minkang543/Microfluidic-RGB-Sensor/Microfluidic Chip Project Report.pdf

# MICROFLUIDIC CHIP PROJECT REPORT

Kaitlyn Nguyen

Emily Gao

Mharlo Borromeo

Min Kang

Ryan Luong

Michelle Tran

ENGR 7B: Introduction to Engineering

University of California, Irvine

Winter 2023

Potato Chip 1

## Table of Contents

Executive Summary | 2
Problem Definition | 3
Introduction | 3
Technical Review / Background | 3
Design Requirements | 3
Design Description | 4
Summary of Design | 4
Design Details | 4
Wiring Diagram | 5
Algorithm Design | 6
Action Item Report | 7
Task Assignment | 7
Gantt Chart | 8
Timeline | 8
Evaluation | 10
Calculations | 10
Calibration Curve | 10
Test Plan | 11
Results & Discussion | 12
Appendix A: SOLIDWORKS Drawings | 14
Appendix B: Bill of Materials | 23
Appendix C: Arduino Code | 24
Appendix D: Volume Calculations | 27
Appendix E: References | 29

## Executive Summary

Our goal for this project was to create a microfluidic system that could detect the concentration of any unknown solution with the use of an rgb sensor. For this project, we had to detect the concentration of fluorescein in the solution given to us. Our team created a chip made of Polydimethylsiloxane (PDMS) along with housing that would prevent light pollution to the chip and hold our electronic components. In order to fill the requirements of the project successfully, our team split up and focused on specialized tasks. This included learning how to laser cut, 3D print, code with arduino, circuit analysis, and learn chemical calibration. As we progressed throughout these ten weeks and learned these new skills, we proceeded with the construction of the system that would meet the design requirements.

We completed the system over a span of ten weeks. The first two weeks were spent brainstorming a design for a system, and deciding the size of the staging wells, detection well, waste well, and channels. After that, our mechanical and electrical hardware team spent the third and fourth week creating a preliminary design for the chip and the housing. Our design was then approved and we spent week five finalizing the details and modifying our design with the advice of our advisor. Once the design was finalized, we began the fabrication process by building the housing, cutting out the chip cover, creating the mold for the PDMS, and fabricating the PDMS chip. We also began the coding process during the sixth week, and this continued with the flowchart, troubleshooting, and debugging up until the final competition. We completed the fabrication of the system during week eight, which is also when we created the stock solutions and began calibration. This also continued until the final competition. We were able to meet our goal of detecting the amount of fluorescein in the solutions with the RGB sensor, though our results were not what we had expected. This could be due to an error in the fabrication of the system itself and the equipment, or some small errors in the code.

Throughout this process we did not only gain technical knowledge in the programs we used, but also the process of engineering. We learned that time management for this project was extremely important, as we had deadlines for several different aspects of the project, as well as the challenging and time consuming process of trial and error. Though we may have had brilliant ideas that should have worked on paper, reality presented us with several challenges. However, this also allowed us to focus on the importance of communication and teamwork, as well as working with others in the field of engineering.

## Problem Definition

I. Introduction
We were tasked to build a microfluidic system that can detect the concentration of fluorescein in a solution. There are many applications to this system that we have studied in class, such as using other solutions with different colors for disease detection, or blood tests. These miniaturized labs help with portability and accessibility, as well as being a cheaper method of testing.
II. Technical Review / Background

The origin of microfluidics is mostly associated with the work done in the late 1960s at Stanford University on chromatography and IBM’s ink jet printer nozzles. Both of these utilized micromechanics to create these microfluidic devices. There is also evidence that hundreds of years earlier, researchers such as Hippocrates (400 BC), Galen (200 AD), and Theophilus (700 AD) were already interested in subjects that pertained to microfluidic technology. Although they didn’t have the devices and technology themselves, the idea of creating microfluidic devices has already been present for several centuries.
In recent years, the advancement of technology has brought on more sophisticated microfluidics. The development has allowed these systems to use less samples and reagents, increased portability, low energy consumption, rapid response, and several other advantages that would help with the analysis of these solutions. There is even potential for connecting these microfluidic devices to smartphones, and taking advantage of the features available in them; especially the optical detection system. ¹
III. Design Requirements

As part of our product specifications, we were given that the feature size should be at least 150 um and the channel width be between 150 um and 400 um. Detection well is designed to store 3 uL of fluorescein solution. As for our structure, we were allowed to use either PDMS and
PMMA, and we decided to use both, one for the chip (PDMS) and the holders with PMMA. We made sure to use gloves during PDMS fabrication to avoid stains as suggested. We 3D printed components (specifically our darkness chamber) and also created a holder to house the LED and an enclosure for the entire system. We made sure that our wires and connectors are completely covered and insulated by threading them through the bottom of the housing platform. Our total cost to build the device was less than $350, as the budget sheet will later on show. Finally, our product deliverables were as follows: the lab-on-a-chip microfluidic device, a detection concentration of an unknown fluorescein solution, the final design report, and the oral presentation.

1 Castillo-León Jaime, and Winnie E. Svendsen. “Chapter 1 Microfluidics and Lab-on-a-Chip Devices: History and Challenges.” Lab-on-a-Chip Devices and Micro-Total Analysis Systems a Practical Guide , Springer International Publishing, Cham, 2015.

## Design Description

I. Summary of Design
Our design for our microfluidic system consists of a chip created by PDMS held together by two holders made of PMMA material. There is an RGB Sensor screwed into a holder made of wood and screwed into the chip, and the chip itself with the sensor is screwed into the housing, which is then covered by a darkness chamber that was 3D printed and painted black with acrylic paint. The top of the housing also holds the breadboard and arduino, which are also connected to the RGB sensor held on top of the chip. In order to prevent as much light entering the system as possible, the wires are fed through two holes that will go under the darkness chamber. The blue LED is held under the housing platform with a small piece of wood, and is connected to a resistor.

II. Design Details

A. Microfluidic Chip (refer to Appendix A. Page 14)
The microfluidic chip contains four staging wells; each with a diameter of 4mm. All four staging wells flow into 150μm channels that meet and flow into a 300μm channel to go into the detection well. The intention of making two different sizes is to prevent backflow with capillary action. To further ensure that there is no backflow, the chip has four capillary valves connected to the staging wells that each have a diameter of 1mm. The 300μm channel to the detection continues to the waste well that has a semi-minor radius of 2.50mm and semi-major radius of 6.40mm.
B. Chip Holder (refer to Appendix A. Page 15 & 16)
Two pieces of PMMA Acrylic were used to sandwich the PDMS chip. This prevented the PDMS material from getting soiled with any dirt from the outside environment. Aside from that, the chip holder was intended to prevent air bubbles that can allow liquid to flow outside of the system
C. RGB Sensor Holder (refer to Appendix A. Page 17)
The RGB sensor holder positions the RGB sensor in a position above the detection well of the PDMS chip to detect fluorescein concentration with the ambient light.
D. Detection Well (refer to Appendix A. Page 14)
The main channel is the 300μm channel, which leads to the elliptical detection well with a semi-minor radius of 1.59mm and semi-major radius of 3mm.
E. Darkness Chamber + Housing (refer to Appendix A. Page 18 & 19)
The darkness chamber (painted black) was 3-D printed and used to cover the RGB sensor to increase light detection for accurate results.
F. Overview/final assembly (refer to Appendix A. Page 20 & 21)
The chip is covered by the Darkness Chamber to ensure that no ambient light interferes with the detection well. The box is 8in x 8in, made out of wood, and we painted the housing and chamber black to ensure the absorption of all light. The Arduino Uno circuit is screwed on next to the darkness chamber and the breadboard is next to it. The wiring from the Arduino circuit goes into the holes we drilled in the box and connects to the chip underneath. There are also multiple tubes connected to the chip which allows us to easily pump different concentrations of fluid into the chip for detection.

III. Wiring Diagram

Our electrical diagram contained an Arduino Uno and RGB sensor to detect the amount of fluorescein concentration in our chip. The way in which the amount of fluorescein could be detected was with how many red LEDs light up during the experiment. We had 8 red LEDs with resistors of the same resistance for all attached to them to demonstrate the amount of fluorescein solution, with one blue LED connected to the bottom of our housing platform. The blue wires signal anything not connected to ground (black) or voltage (red).

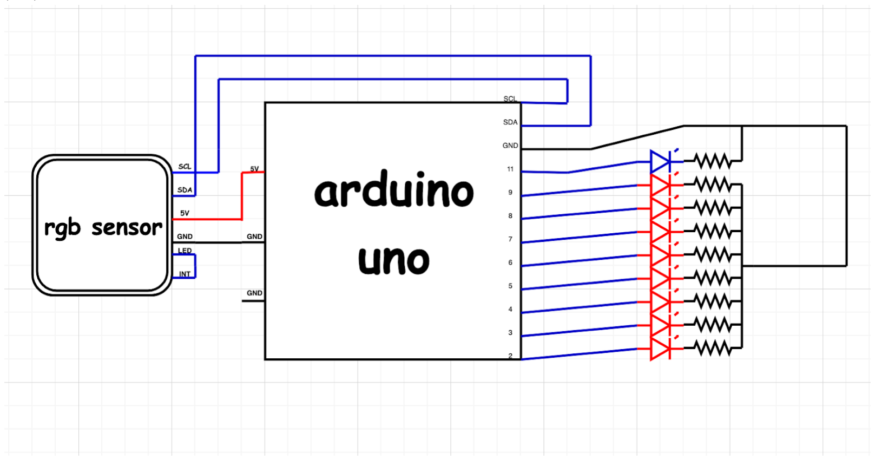
[picture p1: figure]

IV. Algorithm Design

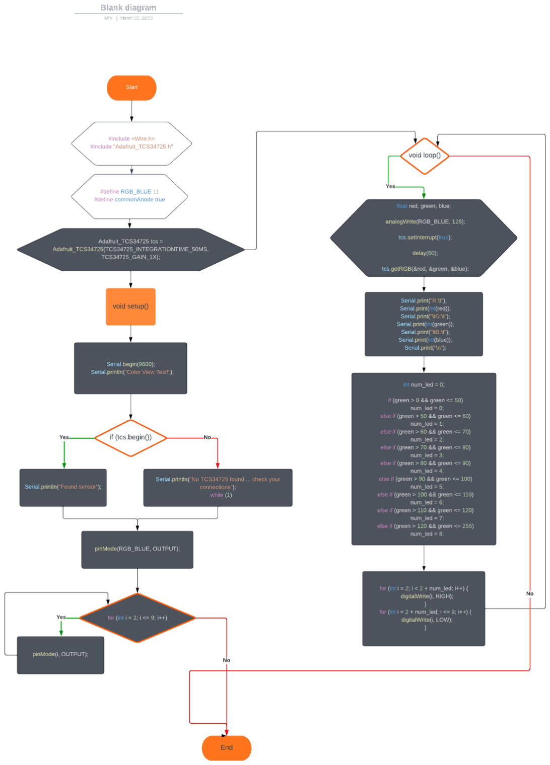
[picture p2: figure]

- Overall very simple flowchart. Goes through initialization and into the two main methods, setup and loop. Loop iterates every 60 Hz. Setup is ran before loop.
- Code:
- First off, the RGB sensor is initialized and turned on to detect RGB values in front of it. The light however that comes with the RGB sensor is not turned on.
- Next, the blue LED is turned on as well. This will shine onto the fluorescein solution in order to allow for excitation. The solution will glow and will be picked up by the RGB sensor and is turned into numerical values.
- The RGB value of green is compared to a set range that determines how many LEDS will be turned on, seen in the “for / else if” section of the code.
- The brighter the fluorescein solution is, the more LEDS that will become activated.

- PSEUDOCODE:

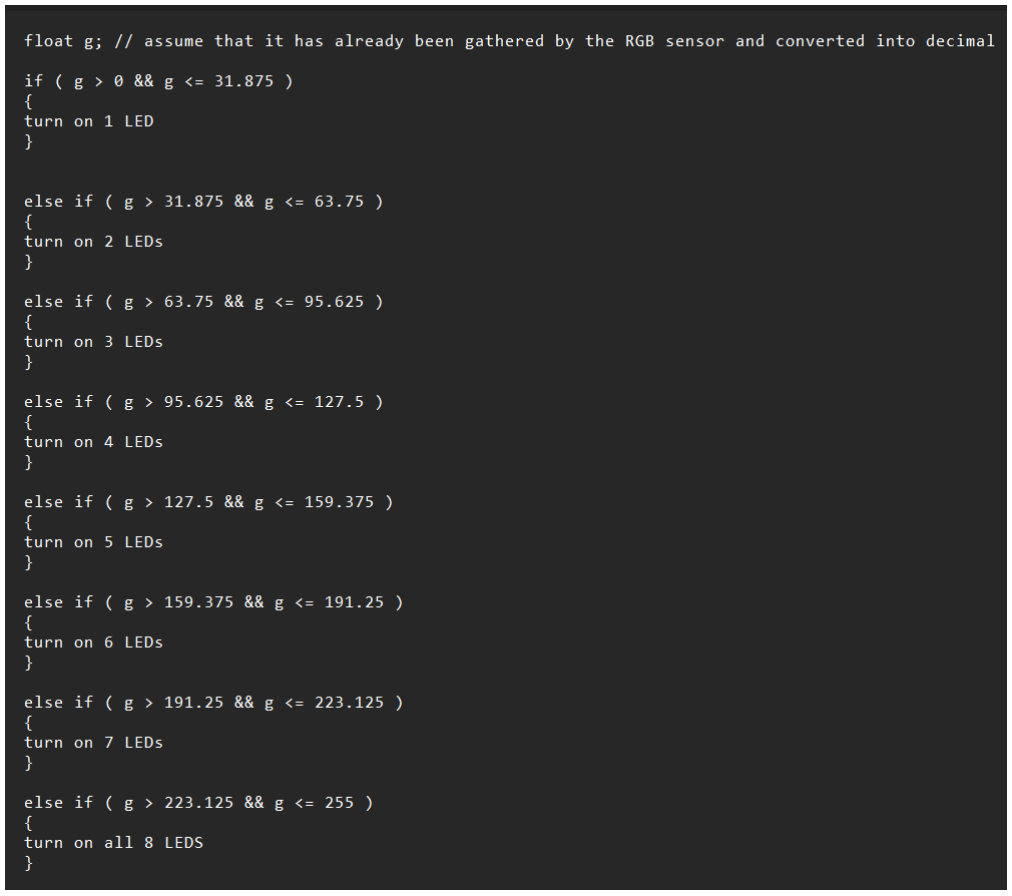
[picture p3: figure]

## Action Item Report

I. Task Assignments

Team Captain: Kaitlyn Nguyen
Chemical & Biomedical: Michelle Tran
Mechanical & Electrical Hardware: Emily Gao, Kaitlyn Nguyen Electrical Software: Mharlo Borromeo, Min Kang, Ryan Luong

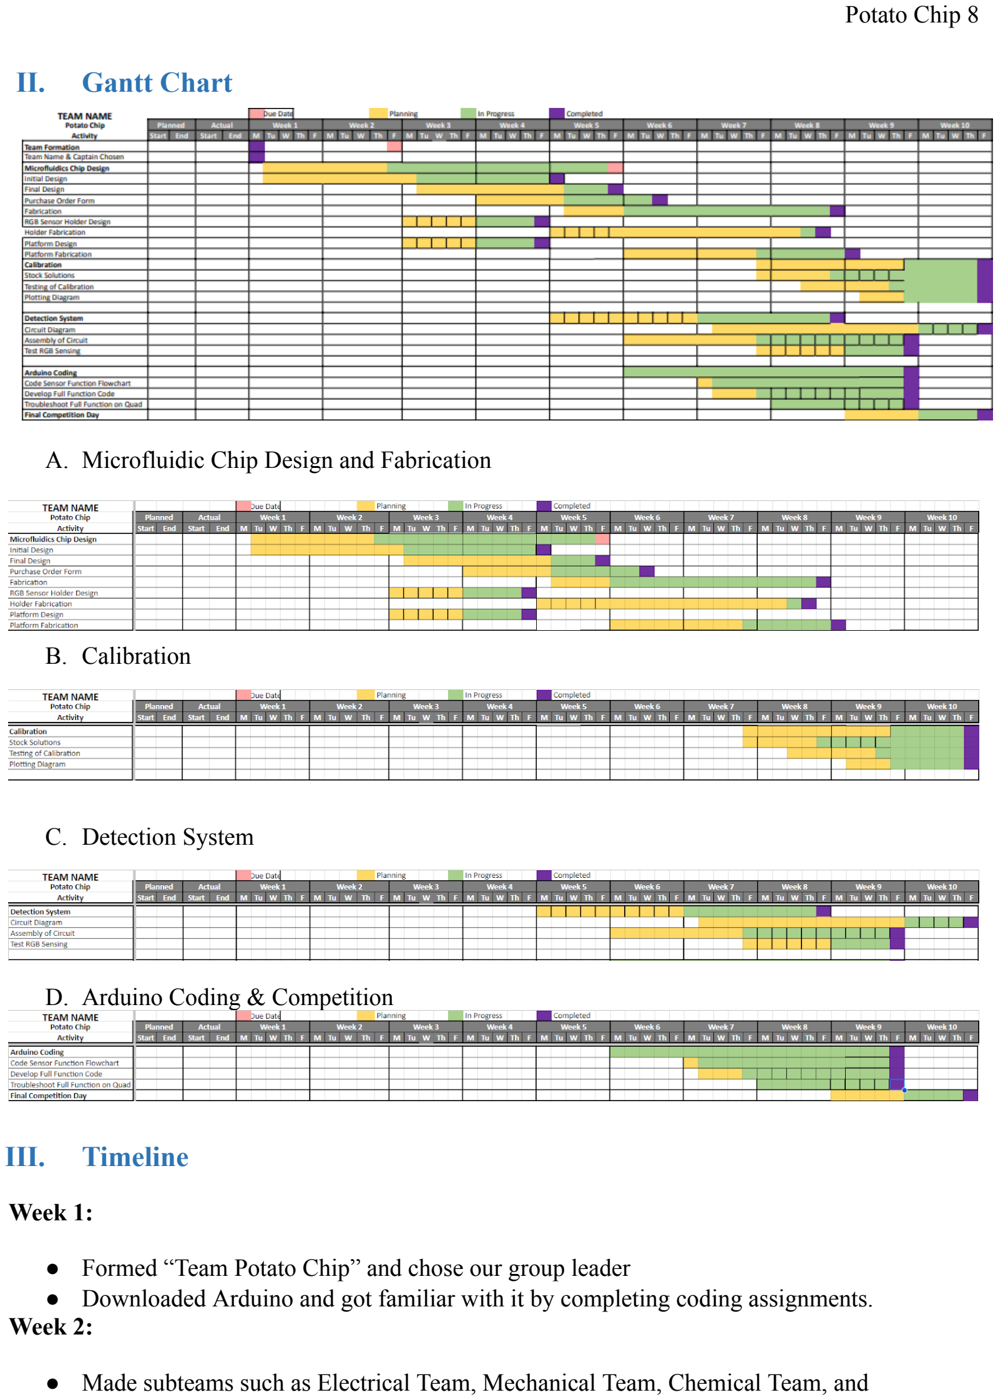
[picture p4: page 9]

II. Gantt Chart

A. Microfluidic Chip Design and Fabrication
B. Calibration
C. Detection System
D. Arduino Coding & Competition

III. Timeline

Week 1:

- Formed “Team Potato Chip” and chose our group leader
- Downloaded Arduino and got familiar with it by completing coding assignments. Week 2:
- Made subteams such as Electrical Team, Mechanical Team, Chemical Team, and

Biomedical Team.
- Familiarizing ourselves with Arduino more and the project as a whole.
Week 3:
- Learned how to clean and prepare a PDMS chip during the lab.
- Created our Action Item Report and planned our goals for the upcoming weeks Week 4:
- Created the base design of the PDMS chip on solidworks with channels and wells
- Prepped the PDMS by cleaning, degassing, and baking it
Week 5:
- The Microfluidics Chip Design was modified with proper calculations and now has a straight channel, then finalized.
- The design for the RGB Sensor Holder as well as the Platform are modified again
- Learned 3D printing and laser cutting for the fabrication process
Week 6:
- Worked on and finished Preliminary Presentation, outlined specifics of PDMS chip and other following components.
- The design specification, calculations, as well as the budget / part list were all finalized.
Week 7:
- Flowchart for coding design and process is started and finished this week
- The housing for the chip was redesigned to take into account LED, screws and
wires.
- The Business Plan was worked on, outlining the audience, purpose, and marketing
- Laser cut some components and 3D-printed the darkness chamber for fabrication, had to paint it to prevent light pollution.
Week 8:
- Actual coding process began and is mostly completed
- The circuit board design was refined to be more compact
- Further work on the business plan
- Finalized Design of housing
Week 9:
- Begin calibration process, ran into some difficulties regarding the LED and sensor
- Continued work on business plan, came up with company name
- Coding was refined
Week 10:
- Presented a finalized business plan.
- Finalized calibration
- Presented our findings with the unknown solutions

## Evaluation

I. Calculations
A. Total volume (sample only, for more detail visit Appendix D. Page 27)
I. Total area of microfluidic chip:
A small cℎannel | 2 1 . 4393375 mm × 4 | 2 5 . 75735 mm
A large cℎannel | 2 1 . 08825 mm × 4 | 2 4 . 353 mm
A capillary valve | 2 0 . 710114027 mm × 4 | 2 2 . 840456108 mm
A staging well | 2 12 . 56633544 mm × 4 | 2 50 . 26798176 mm
A detection well | | 14 . 98539699 mm 2
A waste well | | 50 . 26548246 mm 2
A cℎip | All areas added up together | 128 . 4696673 mm 2
II. | Total volume of microfluidic chip: V cℎip = A cℎip × ℎ cℎip V cℎip = 128 . 4696673 mm
| 2 × 0 . 2 mm
| V cℎip = 25 . 69393346 mm
| 3

II. Calibration Curve

To prepare the 10mL solutions of 250, 500, 750, and 1000 PPM, 25.1 mg of fluorescein powder was measured with a scale. 25 mL of distilled (DI) water was collected with a microliter pipette into a 50 mL tube. The 1000 PPM solution was created by pouring the 25.1 mg of fluorescein powder into the tube with 25 mL of DI water and shaking the capped tube. This 1000 PPM solution was the stock solution used to be diluted into the remaining concentrations. Calculations of how much of the stock solution needed for each concentration are shown below and use the dilution equation C 1V 1 = C 2V 2

| . The amount of DI water to be added was found by
subtracting the volume of 1000 PPM (V 2) from the desired volume (V 1), 10 mL.

Concentration (PPM) | C 1V 1 = C 2V 2 | V 2 needed (mL) | DI water need (mL) (10 -V 2)
250 | (250)(10)=(1000)(V 2) | 2.5 | 7.5
500 | (500)(10)=(1000)(V 2) | 5 | 5
750 | (750)(10)=(1000)(V 2) | 7.5 | 2.5

C1 = desired concentration. V1 = desired volume. C2 =1000 PPM. V2 = mL of stock solution (1000 PPM).
The correct volume of the stock solution needed (V 2) for the concentration was inserted into a new 50 mL tube with a microliter pipette. Its corresponding amount of DI water needed was added with a microliter. The tube was labeled with its concentration. This process was repeated for the three concentrations 250, 500, and 750 PPM. These were the solutions used for calibration.

III. Test Plan

Prior to testing, the upper and lower levels were checked for bubbles. If bubbles were seen between the two PDMS layers, the chip was disassembled to be cleaned then reassembled, making sure the wells and holes for the screws lined up. If bubbles appeared between the top PMMA and PDMS layer, pressure was applied from the top to minimize bubbles. Next, all the unused wells were blocked by inserting a tube with a syringe into those holes. This ensures the liquid flows to the least resistant path towards the detection well.
The code was run to get a general understanding of the RGB values. Distilled (DI) water was inserted with a syringe and tube to test which well had the smoothest flow to the detection well. The far right (fourth from the left) well was determined to have the smoothest flow. It is suspected that this well was best aligned on the PDMS and PMMA layer, allowing the tube to connect better than the others. It was attempted to realign the two layers, though the fourth well continued to flow the easiest.
Starting testing, some of the 250 PPM solution was collected into an empty syringe. The solution was slowly inserted into the fourth well until it filled the detection well. The chip was covered with the darkness chamber to eliminate any outside light. Green and blue RGB values were recorded. The syringe with the solution was replaced with a syringe with DI water, which was used to flush out the solution. This process was repeated with the 500, 750, and 1000 PPM solution. The chip and RGB sensor were not adjusted between calibrations to keep consistency. Between testing of different concentrations, the chip was pushed down if any bubbles were visible on the top layer. Below is our calibration curve from collected data.

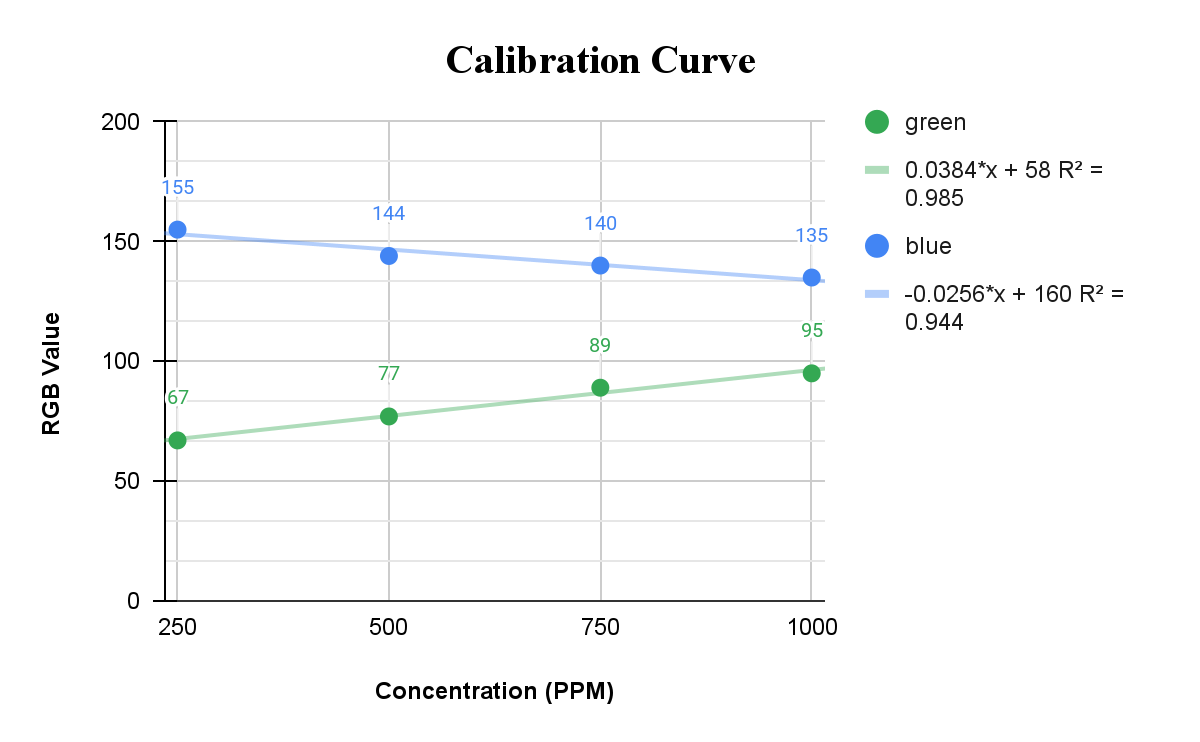
[picture p5: figure]

The points were plotted into a spreadsheet and graphed. The linear regression line fits the data well with an R ² value of 0.985 and 0.944 for the green and blue curve, respectively. The green regression line was y g=0.0384x + 58 , and the blue regression line was y b=-0.0256x + 160 . After creating the curve, the chip was ready for testing. The same procedure as the previous solutions was followed. The channel was flushed with DI water, then Solution A was inserted until it filled the detection well. The chip was covered with the darkness chamber and its green and blue values were recorded. This process was repeated for Solution B.

IV. Results & Discussion
The averages of three trials were used in the calibration equations to determine unknown concentrations. The data and results are below.

Data Collected:
| Avg. Green Value (y g) | Avg. Blue Value (y b)
Solution A | 88.67 | 135.67
Solution B | 114 | 99
Data plugged into equations. y g=0.0384x + 58, y b=-0.0256x + 160 to solve for x, the PPM.

Curve | Green | Blue | Average (of Green & Blue) | Actual Concentration
A (PPM) | 799 | 951 | 875 | 300
B (PPM) | 1458 | 2370 | 1914 | 900

Percent Error
Equation: value observed − value expected
value expected | × 100
Solution A: 875−300
300 × 100 = 191 . 7%
Solution B: 1914−900
900 × 100 = 112 . 7%

This was quite off from the actual concentrations of the solutions, which is suspected to be because of flooding between the top PMMA and PDMS layer. Despite efforts of recleaning and reassembling the chip, bubbles on the top layer remained. With limited time, the unknown concentrations A and B were tested for their green and blue values. There was no flooding during calibration, which is why that curve is consistent. It is probable that the flooding impacted recorded RGB values because the solution(s) covered a larger surface area, increasing the green ambient light. This could explain why the recorded green values are high. Also, the DI water may have mixed with the solution(s) and diluted it. The potentially diluted solution covered the actual solution in the detection well. Therefore, the sensor was not able to detect the true concentration. Some lessons learned were to double check everything, and do extra trials if time allows to catch any mistakes such as using the wrong solution. Problem solving and perseverance was also important for this project.
Potential changes considered are to use a material that would adhere better to eliminate bubbles and ensure all liquid goes through the channels to the detection well. Also, the chip would be redesigned to have a smaller ratio between the well and channel width. Possible solutions could include having a smaller detection well with the current values, or have a larger channel width for the smaller channels. This would ensure that the ratio was even and ensure that the pressure applied would not cause overflow, and the liquid would flow smoothly through the channels.

## Appendix A: SOLIDWORKS Drawings & Structure

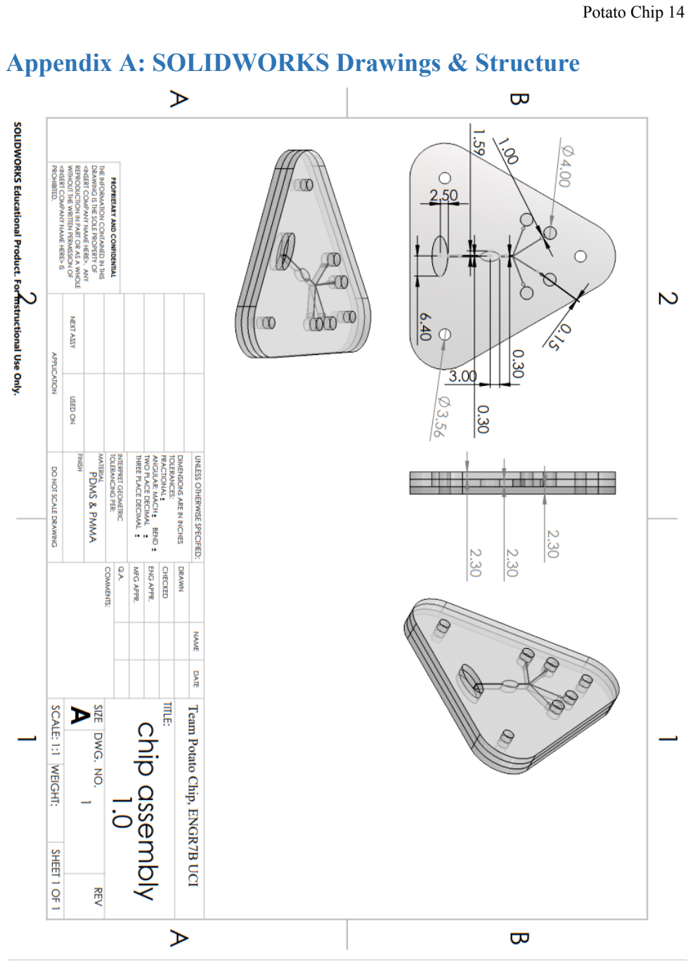
[picture p6: page 15]
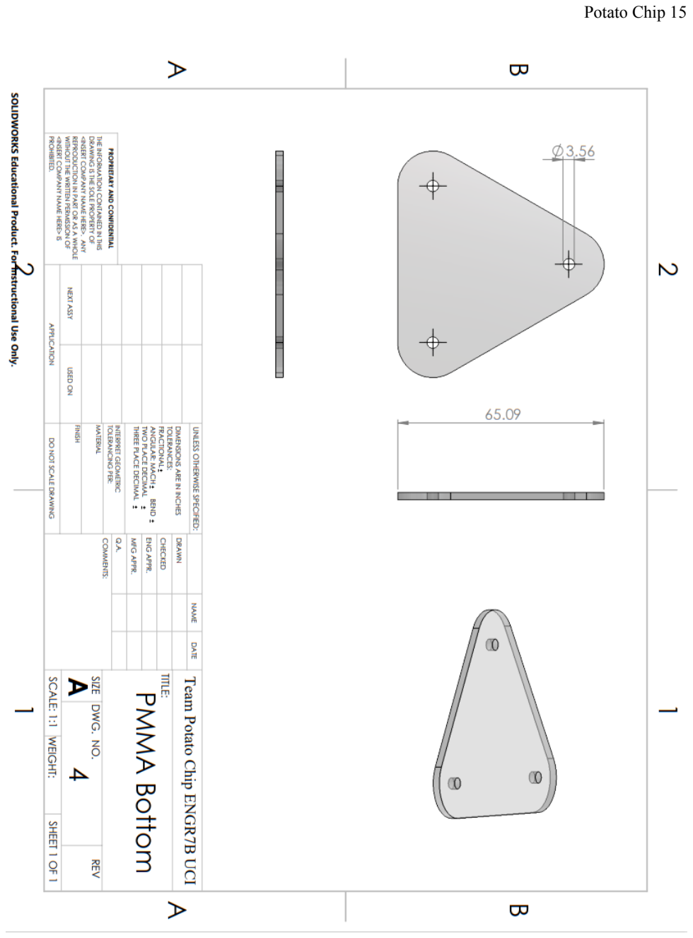
[picture p7: page 16]
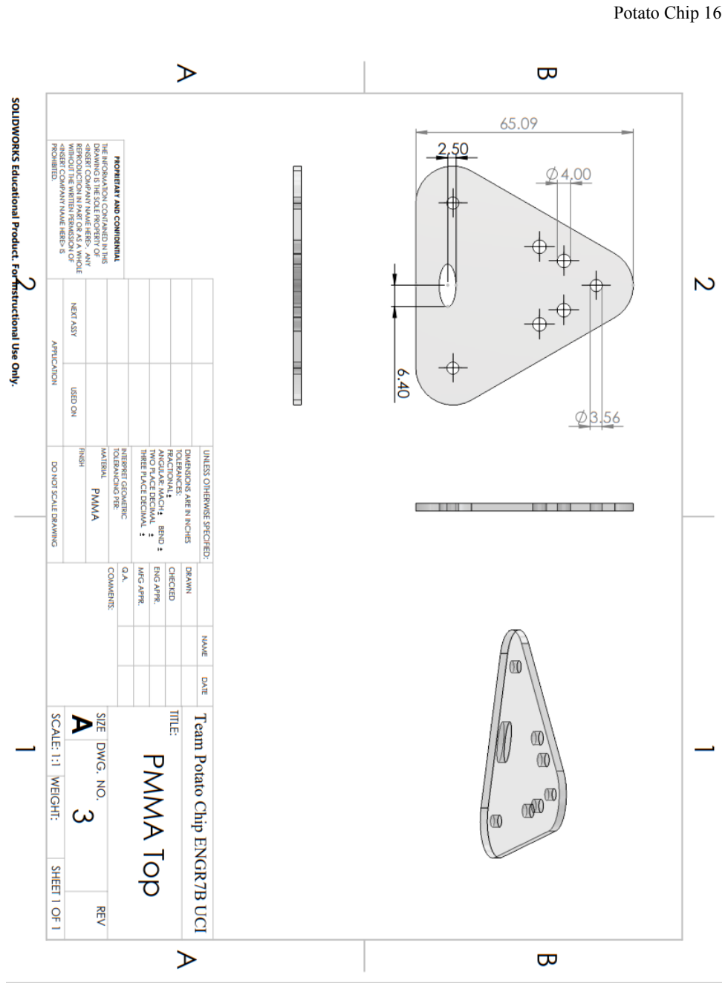
[picture p8: page 17]
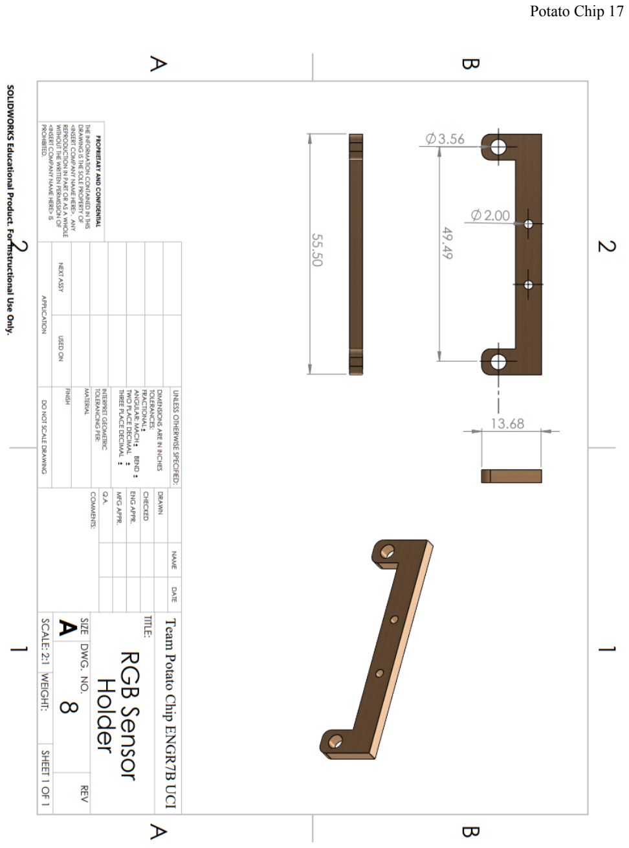
[picture p9: page 18]
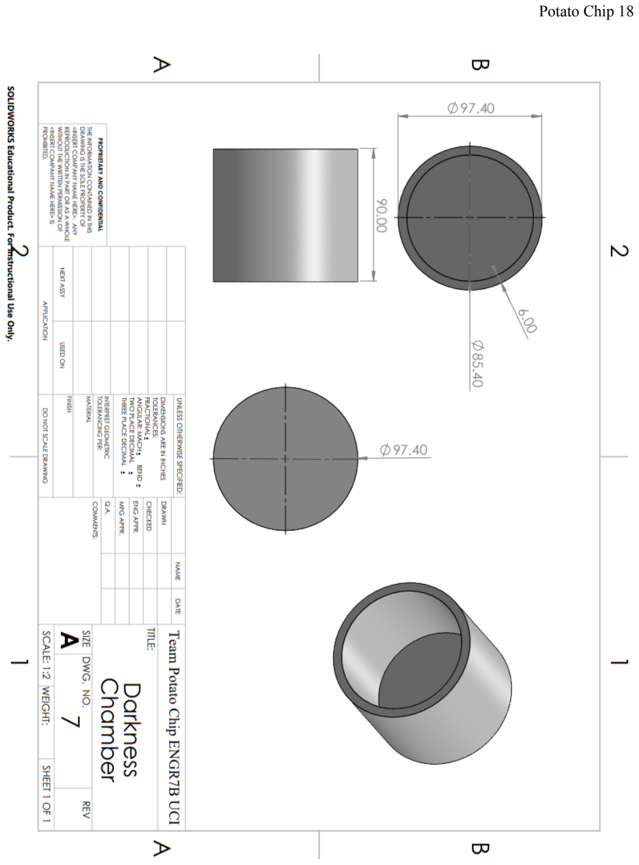
[picture p10: page 19]
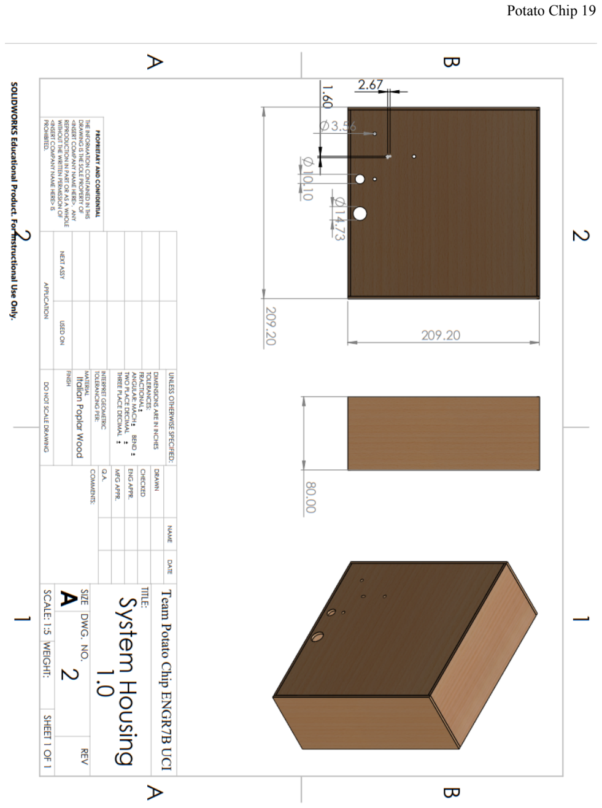
[picture p11: page 20]
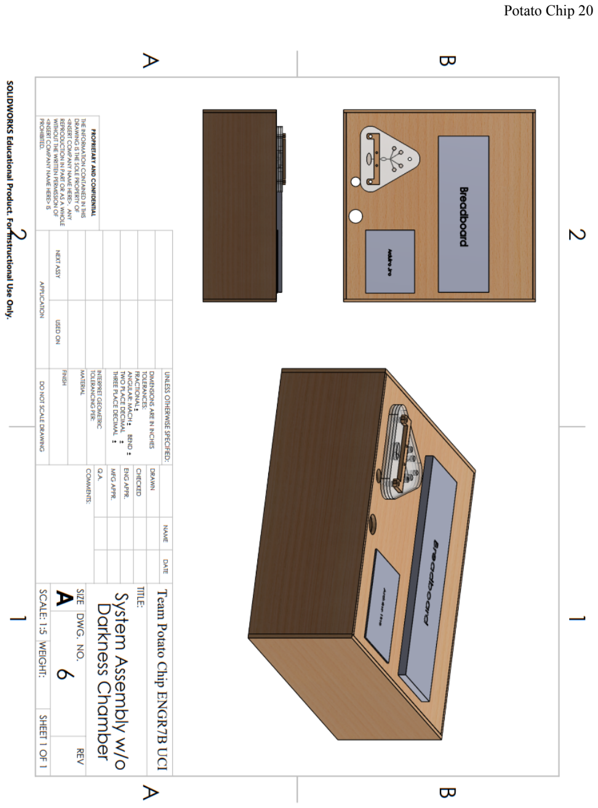
[picture p12: page 21]
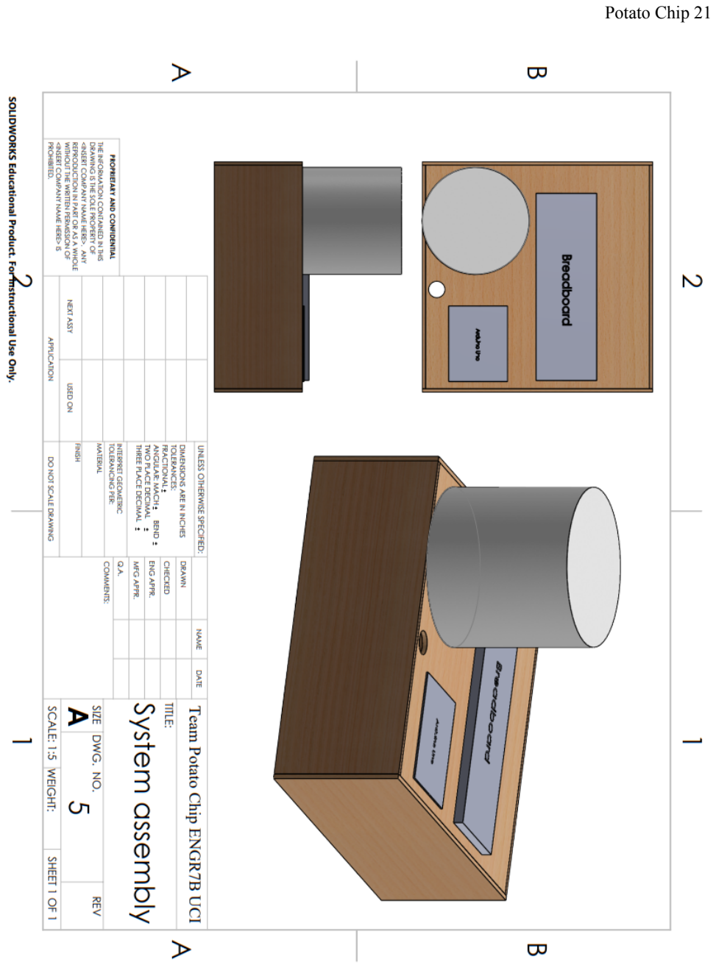
[picture p13: page 22]
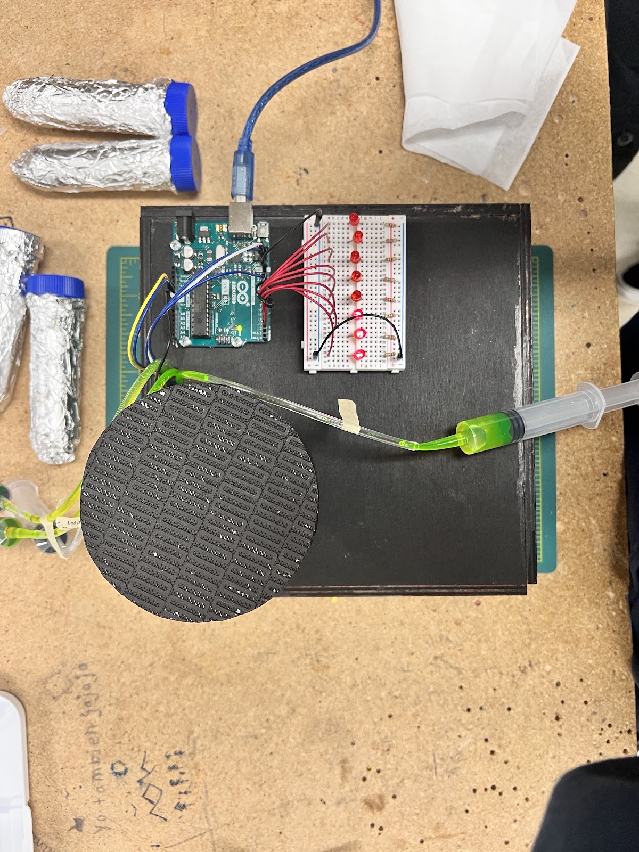
[picture p14: page 23]

## Appendix B: Bill of Materials

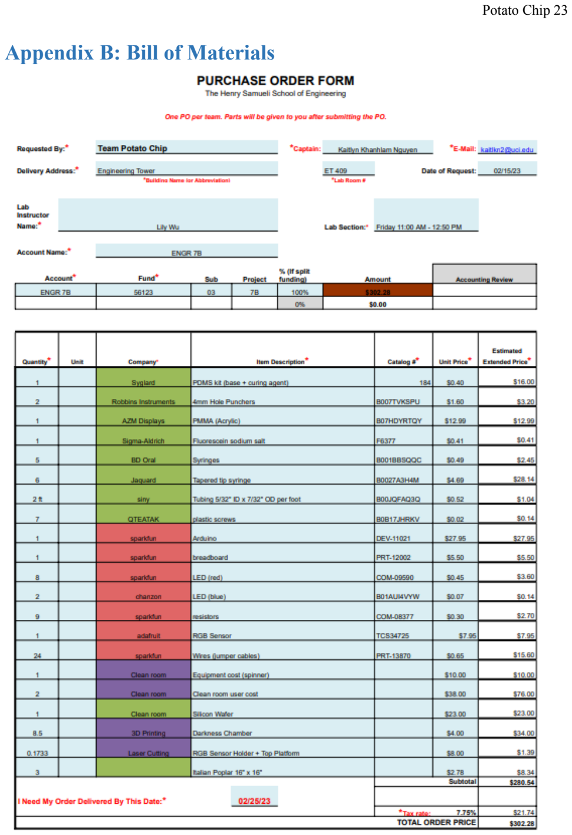
[picture p15: page 24]

## Appendix C: Arduino Code

#include <Wire.h> | // sensor communication

#include "Adafruit_TCS34725.h" // RGB sensor library

#define RGB_BLUE 11

#define commonAnode true

Adafruit_TCS34725 tcs = Adafruit_TCS34725(TCS34725_INTEGRATIONTIME_50MS, TCS34725_GAIN_1X);

void setup() {
// Serial monitor setup
Serial.begin(9600);
Serial.println("Color View Test!");

if (tcs.begin()) {
Serial.println("Found sensor");
} else {
Serial.println("No TCS34725 found ... check your connections"); while (1)
;
}

pinMode(RGB_BLUE, OUTPUT);

for (int i = 2; i <= 9; i++) { pinMode(i, OUTPUT);
}

}

void loop() {
float red, green, blue;

analogWrite(RGB_BLUE, 128);

tcs.setInterrupt(true);

delay(60);

tcs.getRGB(&red, &green, &blue);

Serial.print("R:\t");

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
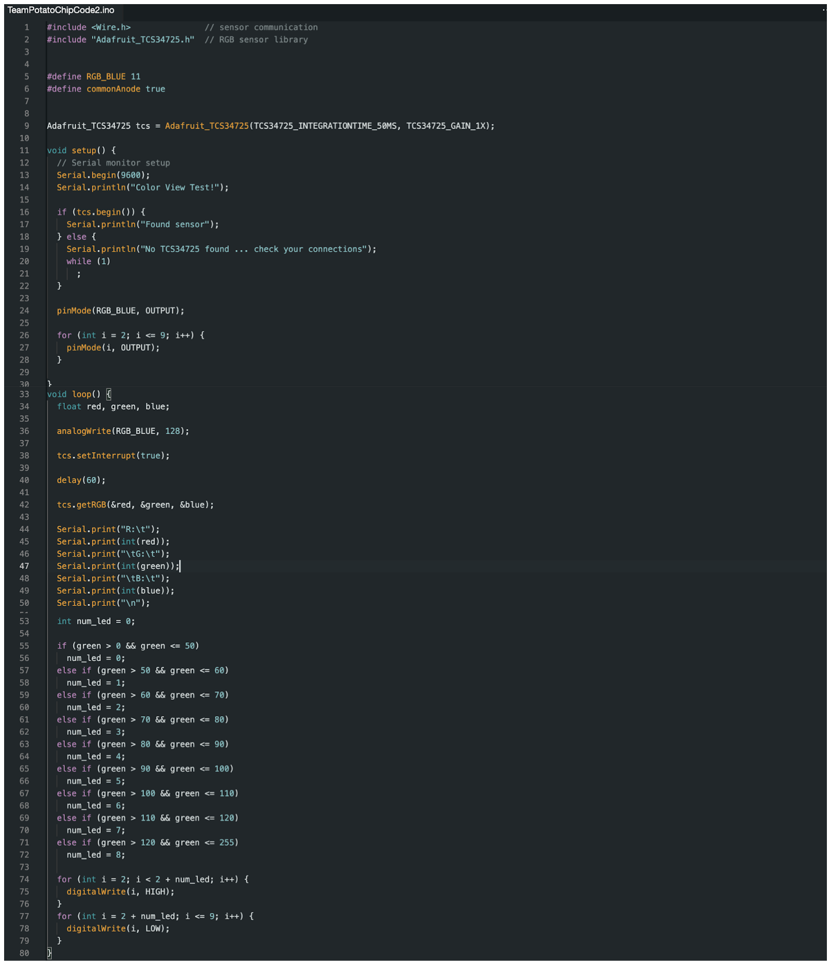
[picture p16: figure]

## Appendix D: Volume Calculations

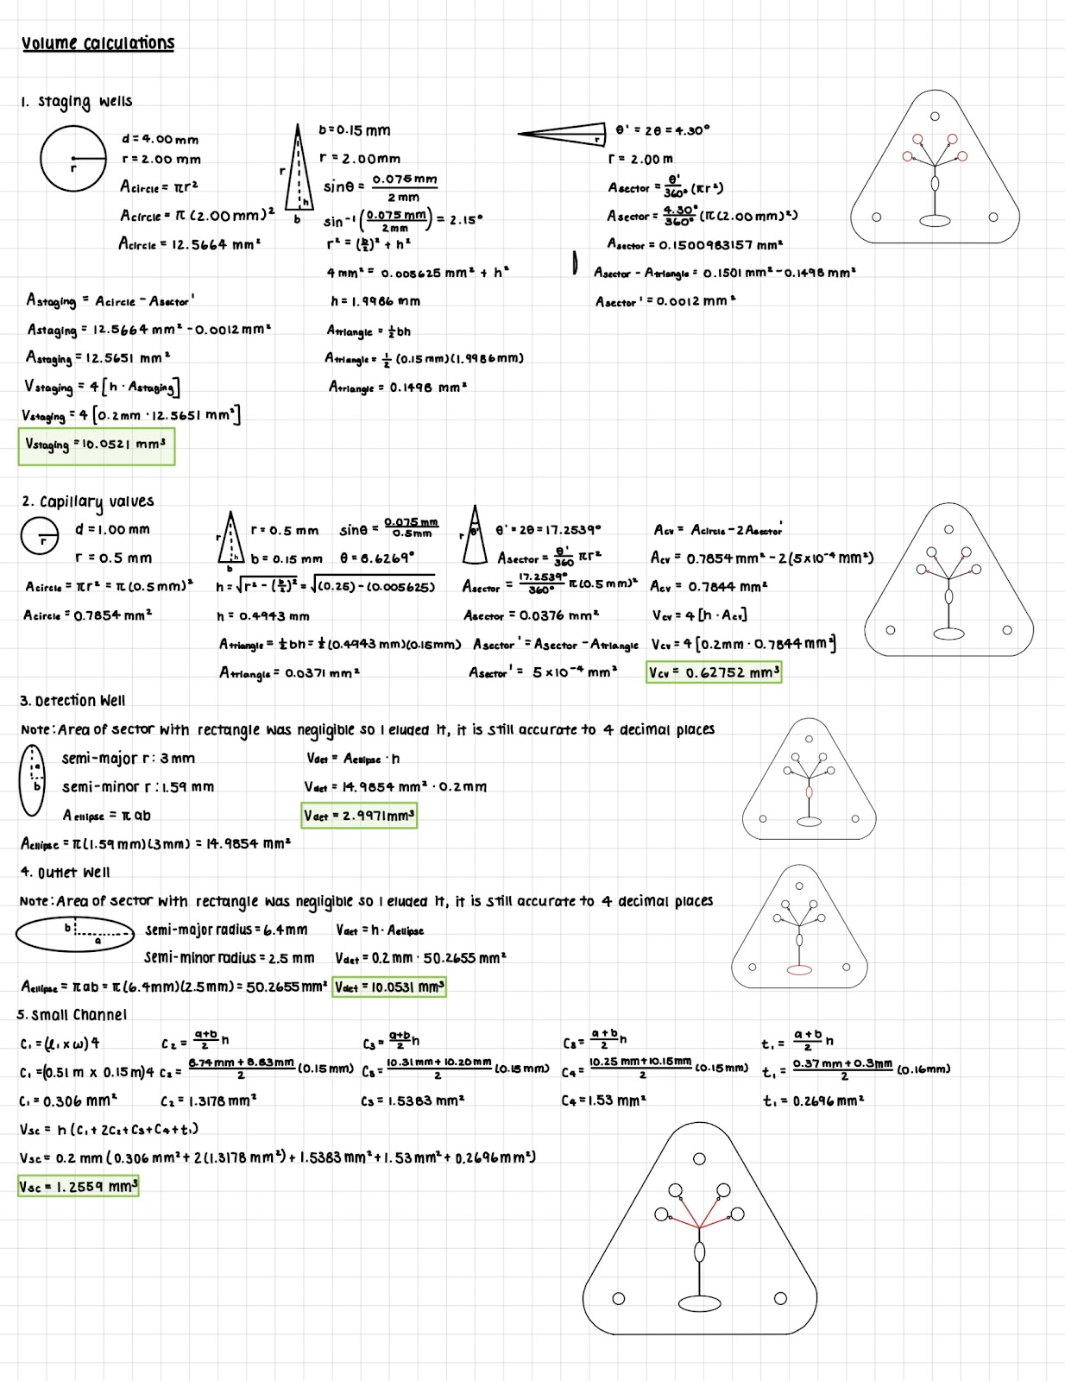
[picture p17: figure]

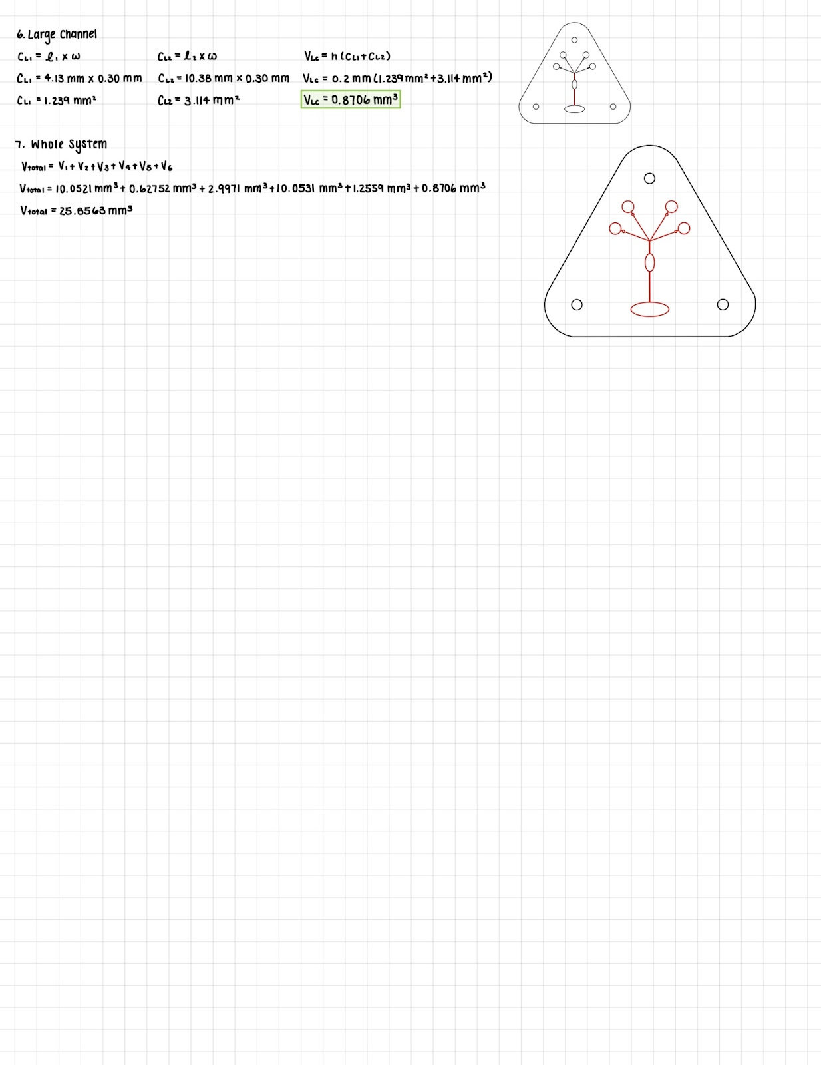
[picture p18: figure]

## Appendix E: References

References

Castillo-León Jaime, and Winnie E. Svendsen. “Chapter 1 Microfluidics and Lab-on-a-Chip Devices: History and Challenges.” Lab-on-a-Chip Devices and Micro-Total Analysis Systems a Practical Guide , Springer International Publishing, Cham, 2015.
